twosilly/WirelessCharge/Document/WechatIMG397.jpeg

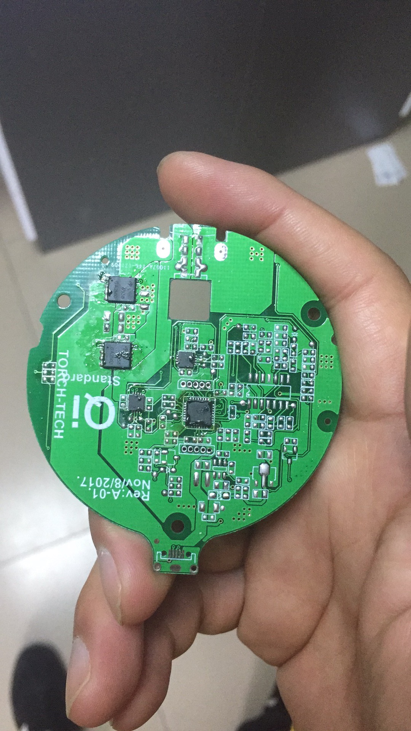
Document/WechatIMG397.jpeg
