twosilly/WirelessCharge/Document/T-FC10W-M.XLS

Tile | Comment | Designator | Footprint | Quantity | Remark
贴片电容 | 0.1uF | C1, C3, C7, C9, C16, C17, C18, C24, C25, C28, C29, C31, C36, C38 | 0603 | 14
贴片电容 | 1uF | C2, C30 | 0603 | 2
贴片电容 | 22uF | C4, C20, C27 | 1206 | 3
贴片电容 | NC | C5, C26 | 0603 | 2
贴片电容 | 10nF | C6, C21 | 0603 | 2
贴片电容 | 4.7nF | C8, C15, C22, C23 | 0603 | 4
贴片电容 | 224J | C10 | 薄膜 | 1 | 备选
贴片电容 | 0.1uF | C11, C12, C13, C14 | 1206 | 4
贴片电容 | 6.8nF | C19 | 0603 | 1
贴片电容 | 10uF | C32, C33, C35, C37 | 0805 | 4
贴片电容 | 10pF | C34 | 0603 | 1
贴片电阻 | 3K 1% | R1, R17, R36 | 0603 | 3
贴片电阻 | 1K 1%, | R2, R6, R8, R32, R33, R39, R40, R41, R42, R43, R44, R45, R46, R47, R49 | 0603 | 15
贴片电阻 | 10K 1%, | R3, R5, R9, R10, R11, R18, R19, R26, R27, R29, R30, R38, R50, R53 | 0603 | 14
贴片电阻 | 10R 5% | R4, R22 | 0603 | 2
贴片电阻 | 68K 1% | R7, R21 | 0603 | 2
贴片电阻 | 7.5K 1% | R12 | 0603 | 1
贴片电阻 | 120K 1% | R13 | 0603 | 1
贴片电阻 | 100K 1% | R14, R23, R25, R52 | 0603 | 4
贴片电阻 | 510K 5% | R15 | 0603 | 1
贴片电阻 | 1.5K 1% | R16 | 0603 | 1
贴片电阻 | 33K 1% | R20 | 0603 | 1
贴片电阻 | 1M 1% | R24 | 0603 | 1
贴片电阻 | 22mR 5% | R28 | 1206 | 1
贴片电阻 | 22K 1% | R31 | 0603 | 1
贴片电阻 | 4.7K 1% | R34, R35 | 0603 | 2
贴片电阻 | 2K 1% | R37 | 0603 | 1
贴片电阻 | 330K 1% | R48 | 0603 | 1
贴片电阻 | 20K 1% | R51 | 0603 | 1
热敏电阻 | TAJ103K 5% | RT1 | 0603 | 1
二极管 | BAT54H | D1, D2 | SOD-323 | 2
二极管 | 1N4148 | D3, D4 | SOD-323 | 2
二极管 | 1N5819 | D5 | SOD-123 | 1
贴片电感 | NR-3R3M | L10 | L3015T | 1
磁板电感 | 磁板 | L1 | 磁板 | 1
LED | LED双 | L2 | LED0603双 | 1
LED | LED | L3, L4, L5, L6, L7, L8, L9 | LED0802 | 7
MOSFET | AON6938 | M1, M2 | QFN-5*6 | 2
MOSFET | 2N7002 | M3, M4 | SOT-23-L | 2
IC | LM324 | U1 | SOP-14 | 1
IC | NCP81155 | U2, U3 | QFN-3*3-1 | 2
IC | GVM32F | U4 | QFN-32PIN | 1
IC | ME6208A50PG | U5 | SOT-89 | 1
IC | SDB628 | U6 | SOT-23-6 | 1
USB | MUSB牛 | USB1 | MICRO-USB牛 | 1
 |  |  |  | 118
