twosilly/WirelessCharge/Document/T-FC10W-M贴片图.pdf

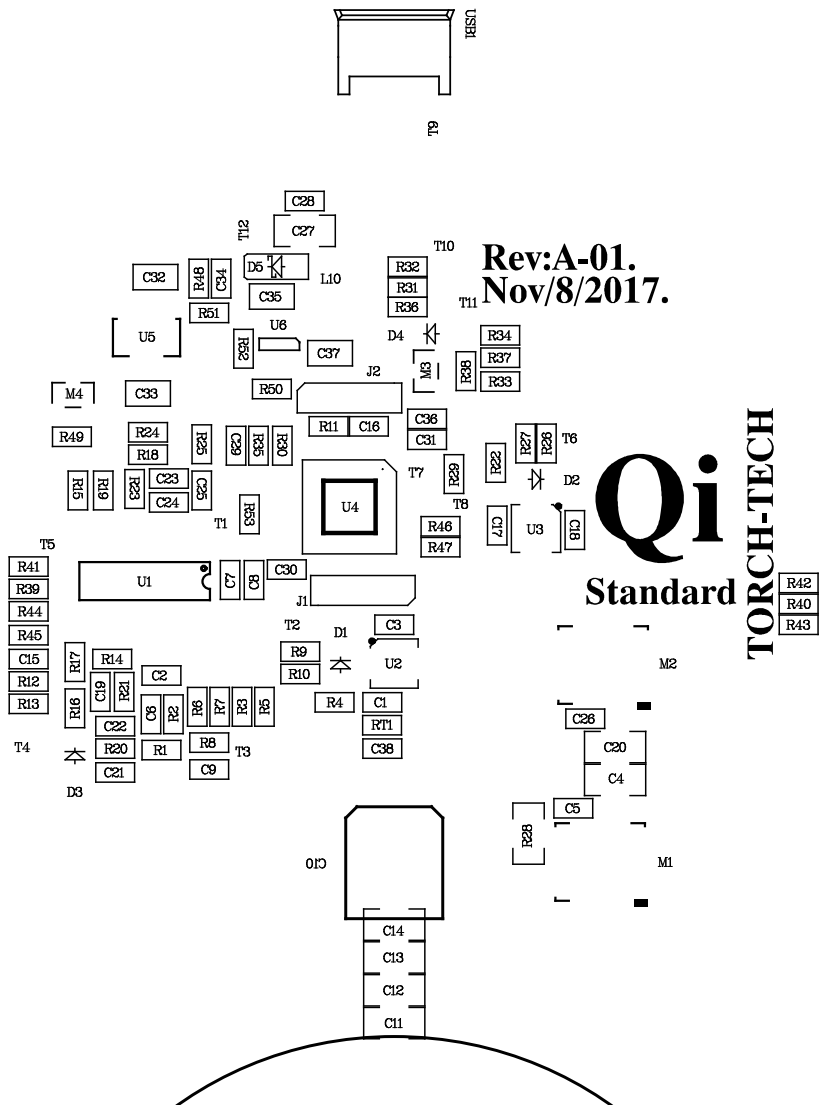
[picture p36: page 1]
