twosilly/WirelessCharge/Document/新唐兼容Qi 1.1标准无线充电发射端参考设计原理图.pdf

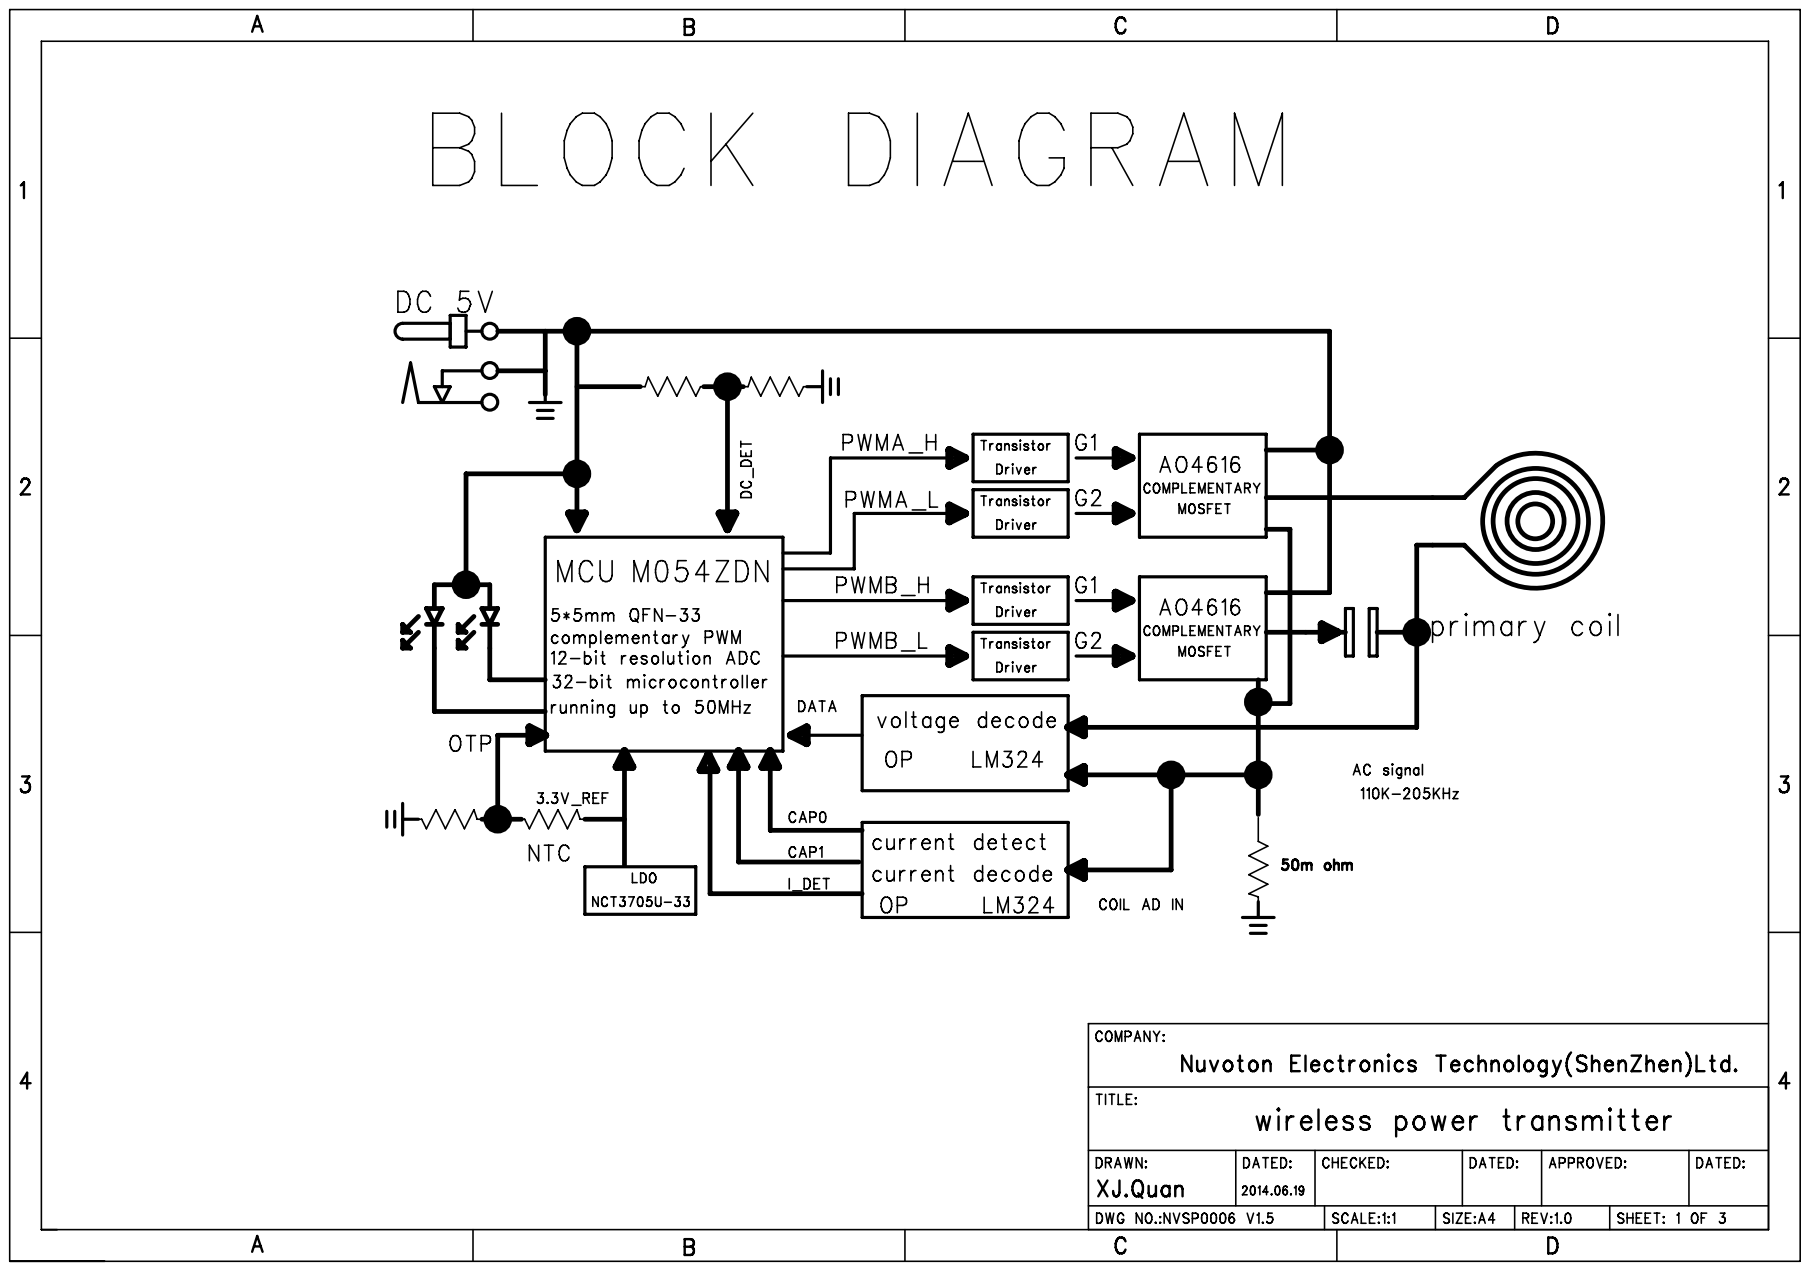
[picture p37: page 1]

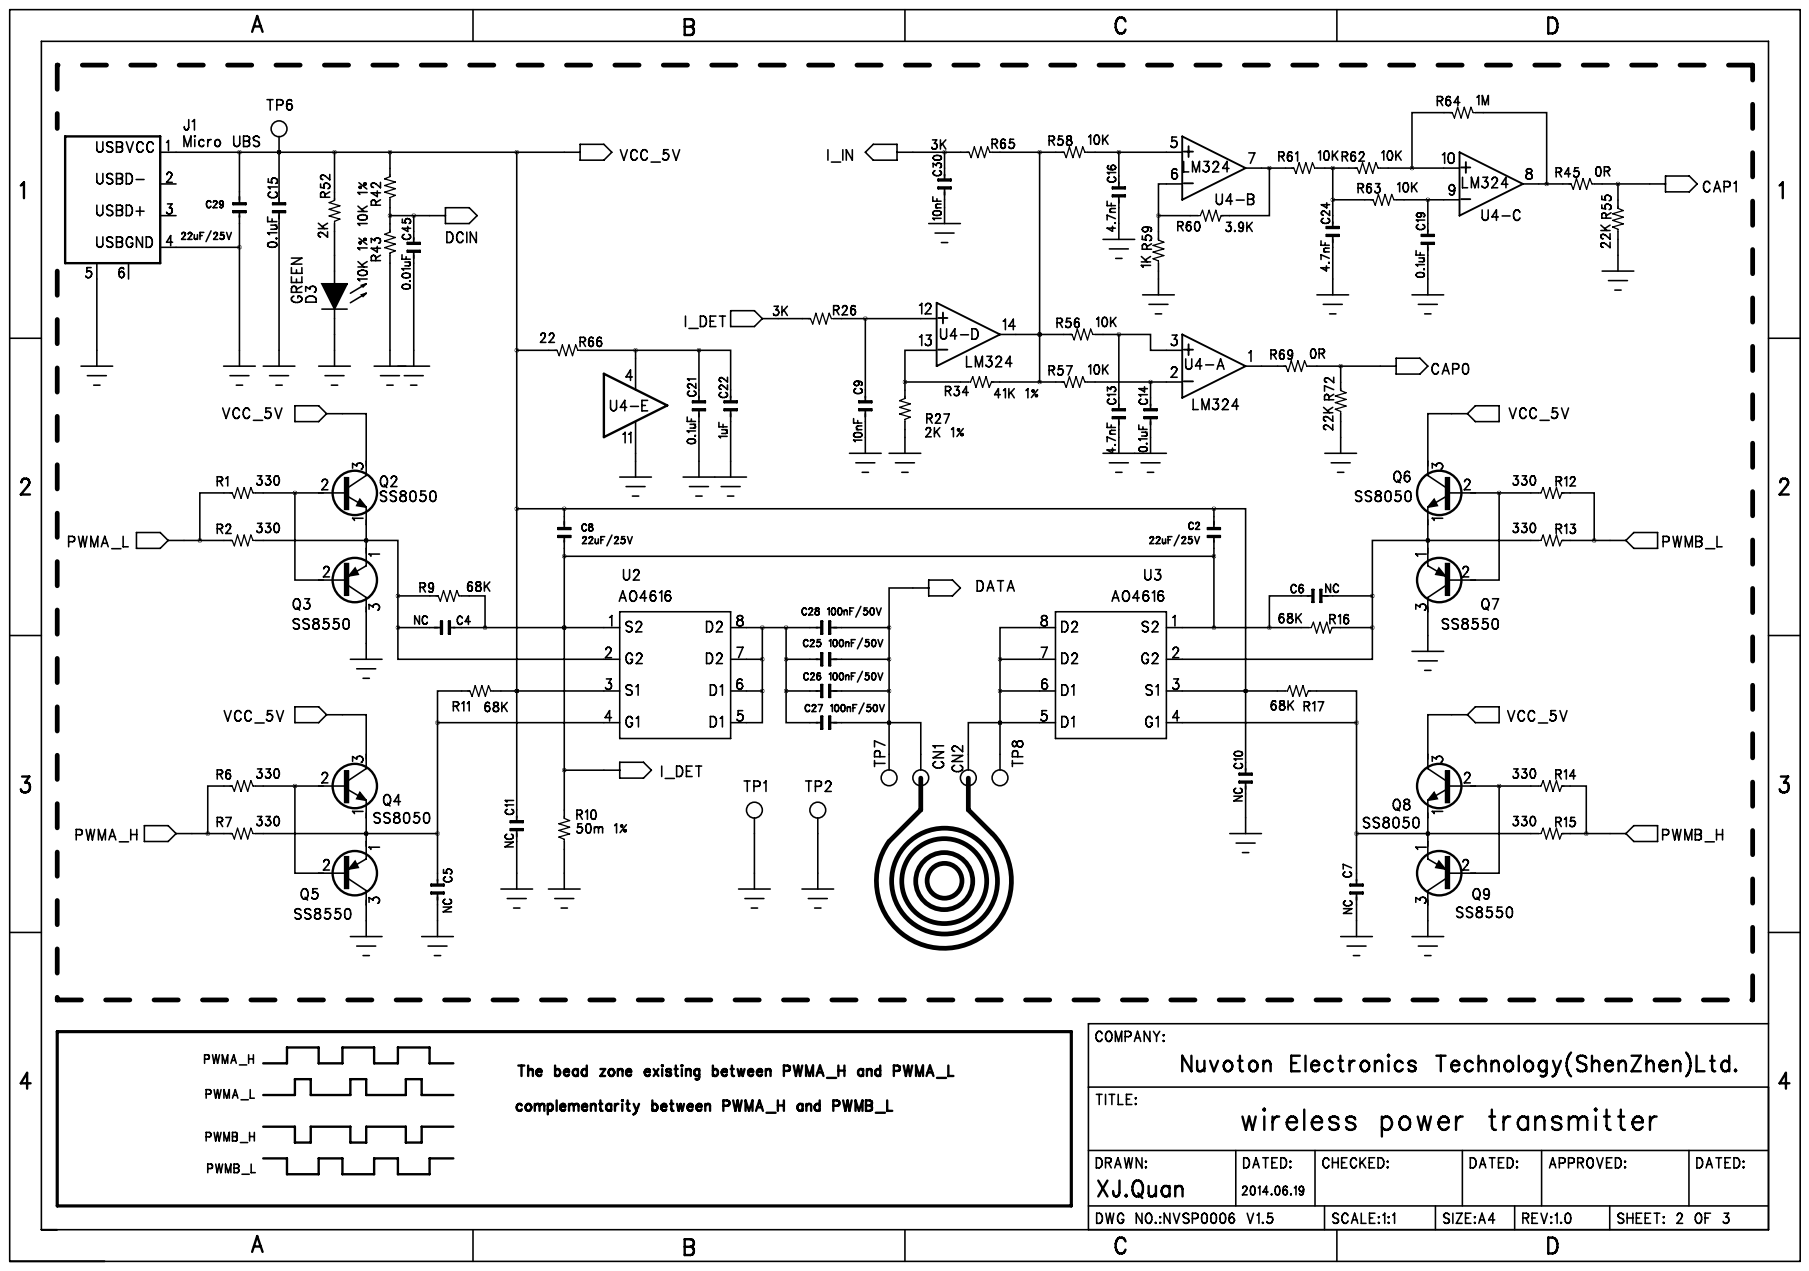
[picture p38: page 2]

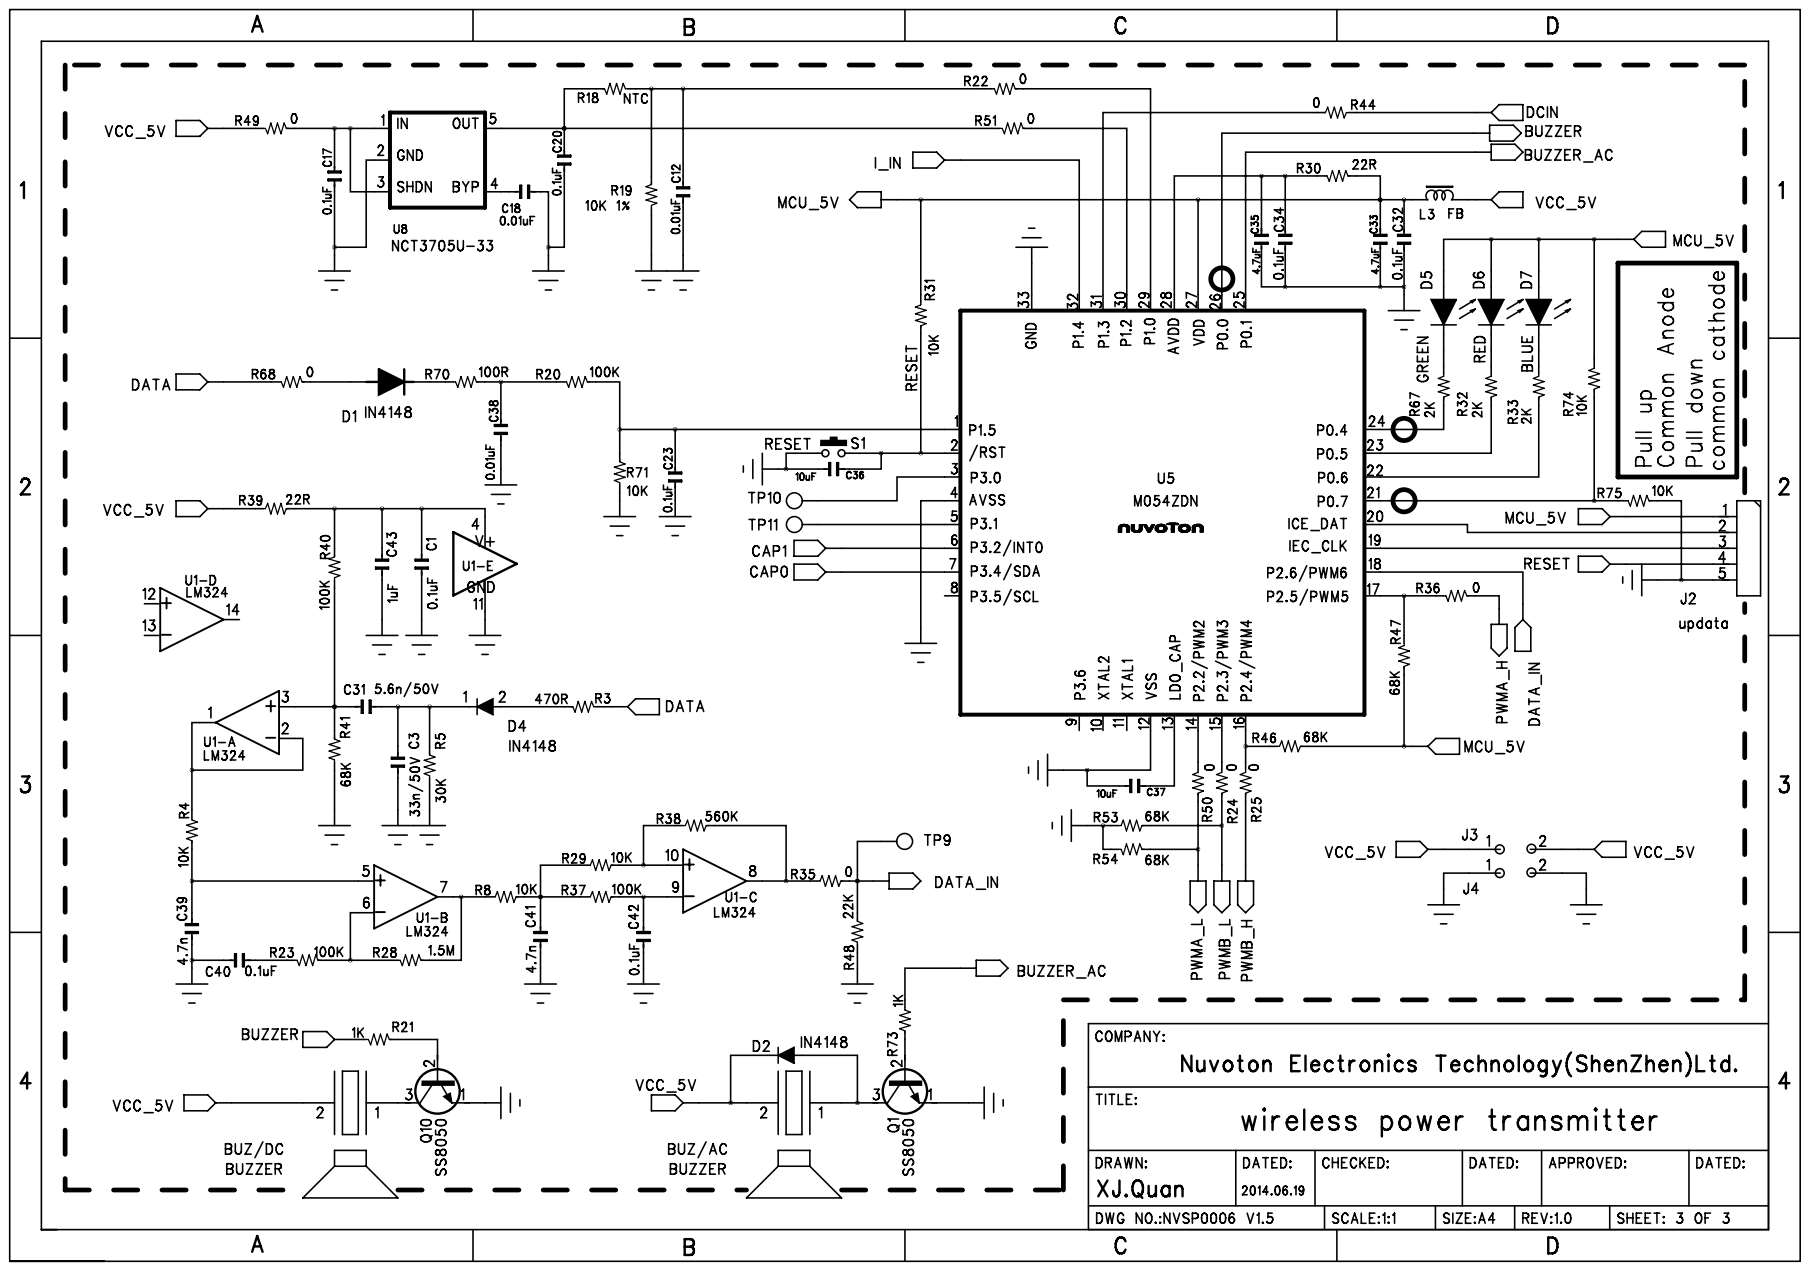
[picture p39: page 3]
