twosilly/WirelessCharge/(list of files, drawings)

Other design files:
Document/T-FC10W-M.SchDoc
PCBProject/T-FC10W-M.SchDoc
