twosilly/WirelessCharge/Program/WirelessCharge/User/BSP/BSP.c

#include "BSP.h"

void Variable_Init(void)
{
  QiStatus = Select;   //选择阶段
  memset(&QiConfig, 0, sizeof(struct QiConfig_Struct)); 
  memset(&PID, 0, sizeof(struct PID_Struct));
}



void BSP_Init(void)
{
  Variable_Init();
  
  UART_Init(115200);
  LED_Init();
  SysTick_Init();
  MagneticField_Init();
  ADC_Init();
  Decode_Init();
  PID_Init();
  QC_Init();
}
