twosilly/WirelessCharge/(commit log)

2017-11-17 new file
    [T-FC10W-M.SchDoc]
2017-11-27 增加一个文档
